bhtyrbyr/robotKolBitirmeProjesi/3D/Motaj/Robot Kol Montaj.SLDASM

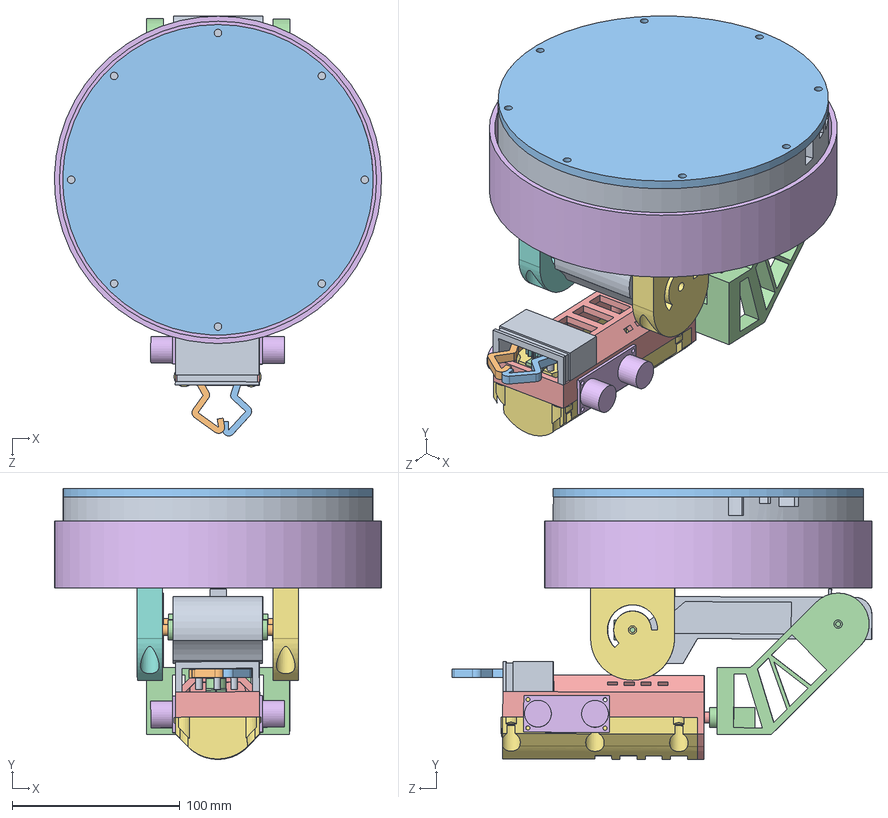
[picture p23: CAD file, 2022-05-09]
3D/Motaj/Robot Kol Montaj.SLDASM
194.9 x 161.5 x 250.3 mm
alt-alan-dönmez
stm32f4-prototip
alt-alan-kapak
Servomotor-mg90s x 7
servomotor-mg90s-180°bağlantı-parçası x 2
döner-parça-alt
yeni-döner-parça-bağlantı
yeni-döner-parça-bağlantı-2
kol-1-ilk-tasarım
servomotor-mg90s-90°bağlantı-parçası x 4
ilk-kol-kapak-tasarım
kol-2-parça-1-test
kol-3-alt-parça-test
HC-SR04 x 2
kol-3-kapak-test
Metric - Spur gear 1M 10T 14.5PA 5FW ---S10N75H50L4N x 2
çark-kutusu
kol-uzun
kısa-kol-güncel
