bhtyrbyr/robotKolBitirmeProjesi/3D/Parçalar/alt-alan-kapak.SLDPRT

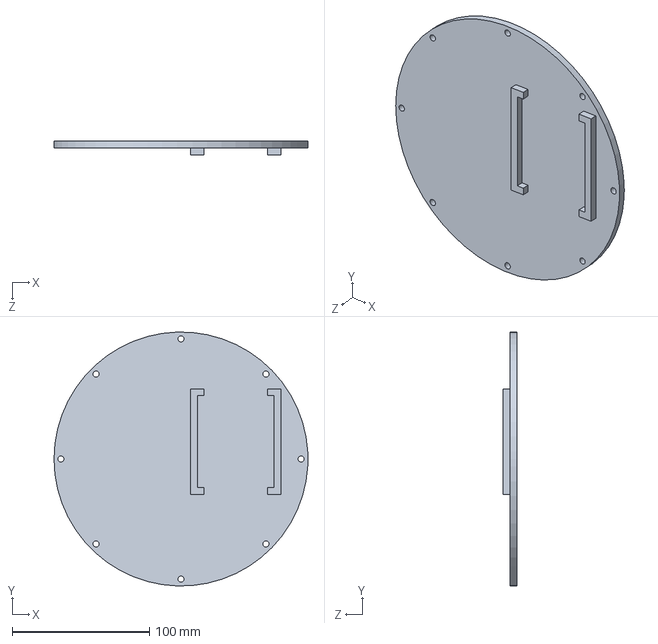
[picture p24: CAD file, 2022-05-09]
3D/Parçalar/alt-alan-kapak.SLDPRT
185.0 x 184.9 x 10.0 mm
