bhtyrbyr/robotKolBitirmeProjesi/3D/Parçalar/döner-parça-alt-bağlantı-2.SLDPRT

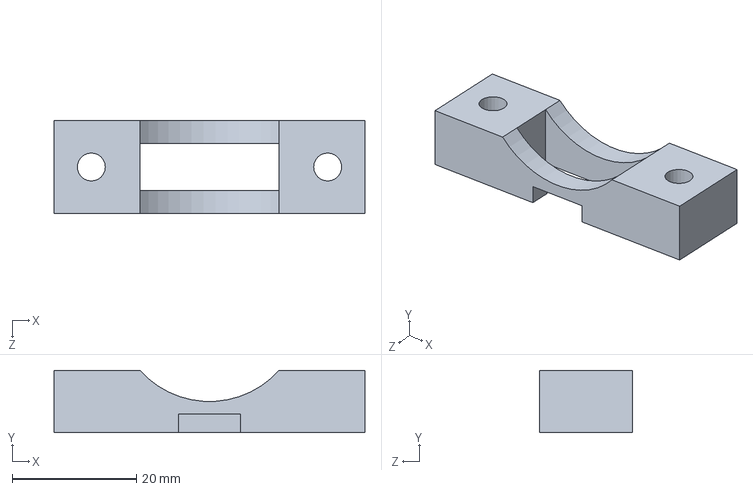
[picture p25: CAD file, 2022-05-09]
3D/Parçalar/döner-parça-alt-bağlantı-2.SLDPRT
50.0 x 10.0 x 15.0 mm
