bhtyrbyr/robotKolBitirmeProjesi/3D/Parçalar/döner-parça-alt.SLDPRT

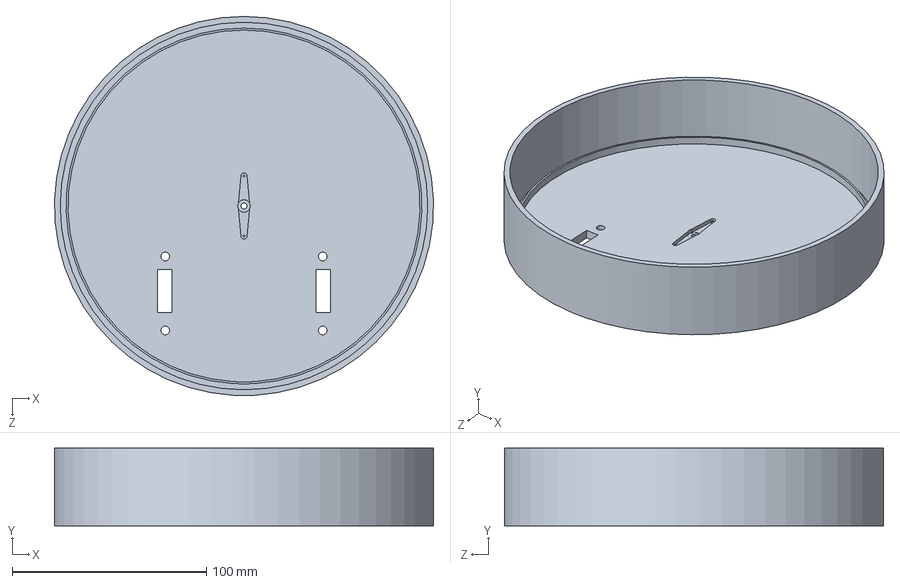
[picture p26: CAD file, 2022-05-09]
3D/Parçalar/döner-parça-alt.SLDPRT
194.9 x 40.0 x 195.0 mm
