bhtyrbyr/robotKolBitirmeProjesi/3D/Parçalar/servomotor-mg90s-90°bağlantı-parçası.SLDPRT

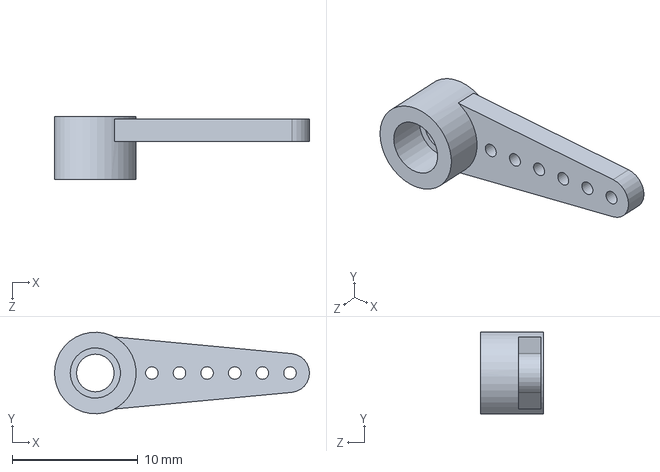
[picture p27: CAD file, 2022-05-09]
3D/Parçalar/servomotor-mg90s-90°bağlantı-parçası.SLDPRT
20.3 x 6.49 x 5.00 mm
