bhtyrbyr/robotKolBitirmeProjesi/3D/Parçalar/stm32f4-prototip.SLDPRT

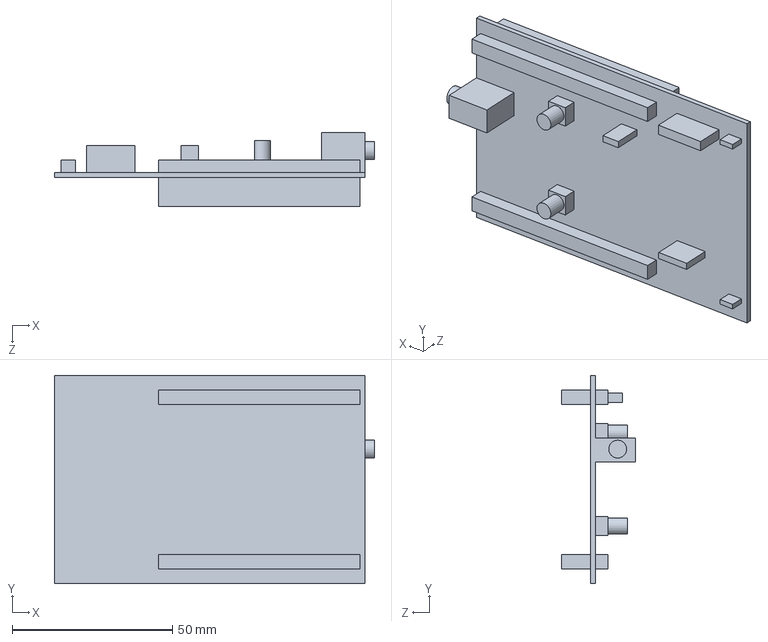
[picture p28: CAD file, 2022-05-09]
3D/Parçalar/stm32f4-prototip.SLDPRT
100.0 x 65.0 x 23.0 mm
