bhtyrbyr/robotKolBitirmeProjesi/3D/Parçalar/kol-uzun.SLDPRT

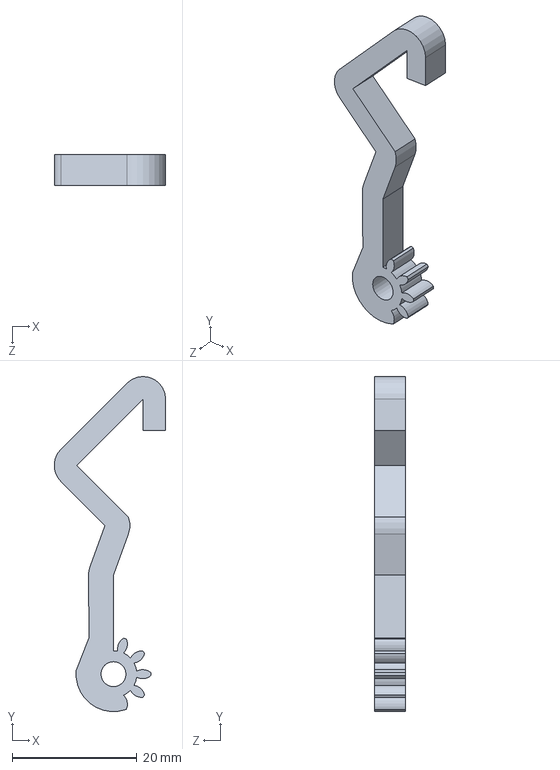
[picture p29: CAD file, 2022-05-09]
3D/Parçalar/kol-uzun.SLDPRT
17.8 x 53.6 x 5.00 mm
