bhtyrbyr/robotKolBitirmeProjesi/3D/Parçalar/HC-SR04.SLDPRT

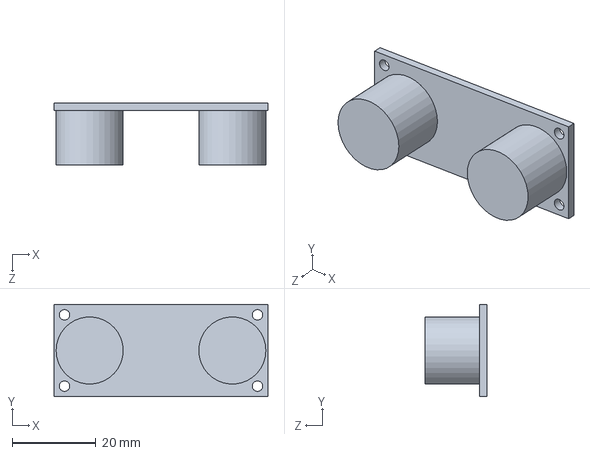
[picture p30: CAD file, 2022-05-09]
3D/Parçalar/HC-SR04.SLDPRT
51.0 x 22.0 x 14.8 mm
