bhtyrbyr/robotKolBitirmeProjesi/3D/Parçalar/alt-alan-dönmez.SLDPRT

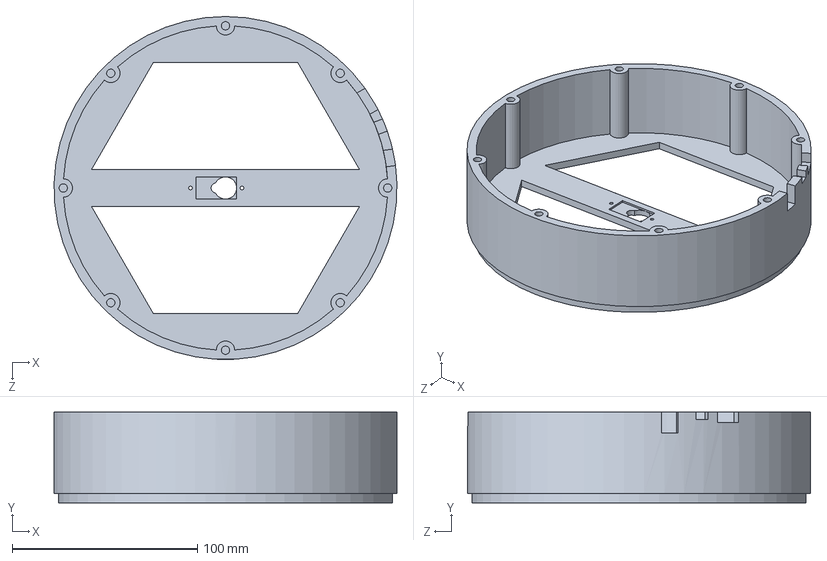
[picture p31: CAD file, 2022-05-09]
3D/Parçalar/alt-alan-dönmez.SLDPRT
184.9 x 49.0 x 185.0 mm
