bhtyrbyr/robotKolBitirmeProjesi/3D/Parçalar/kol-1-ilk-tasarım.SLDPRT

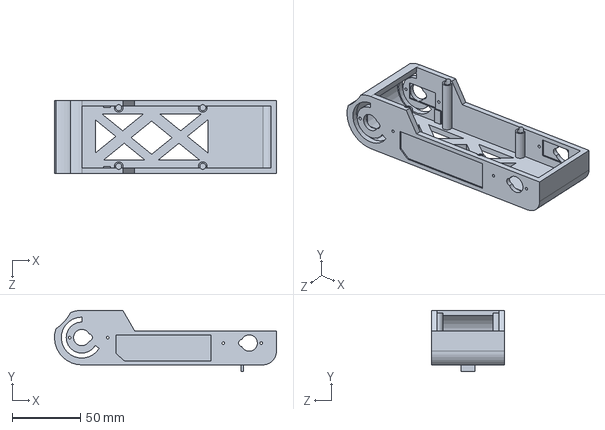
[picture p32: CAD file, 2022-05-09]
3D/Parçalar/kol-1-ilk-tasarım.SLDPRT
162.5 x 45.0 x 53.4 mm
