bhtyrbyr/robotKolBitirmeProjesi/3D/Parçalar/Servomotor-mg90s.SLDPRT

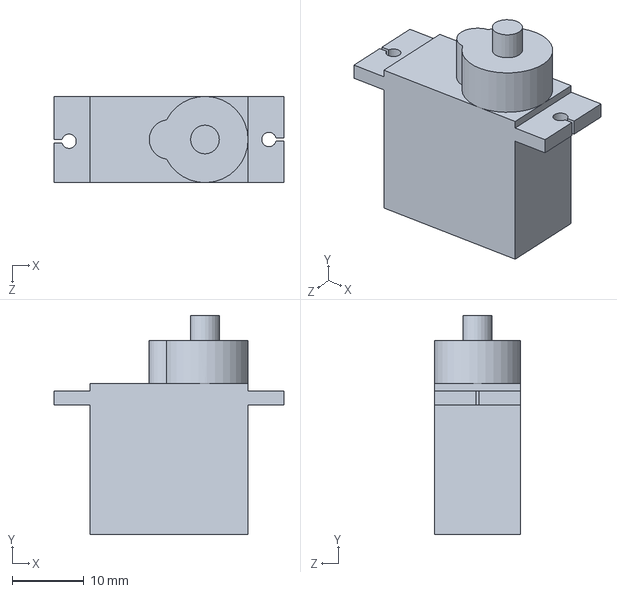
[picture p33: CAD file, 2022-05-09]
3D/Parçalar/Servomotor-mg90s.SLDPRT
32.0 x 30.5 x 12.0 mm
