bhtyrbyr/robotKolBitirmeProjesi/3D/Parçalar/pca9685.SLDPRT

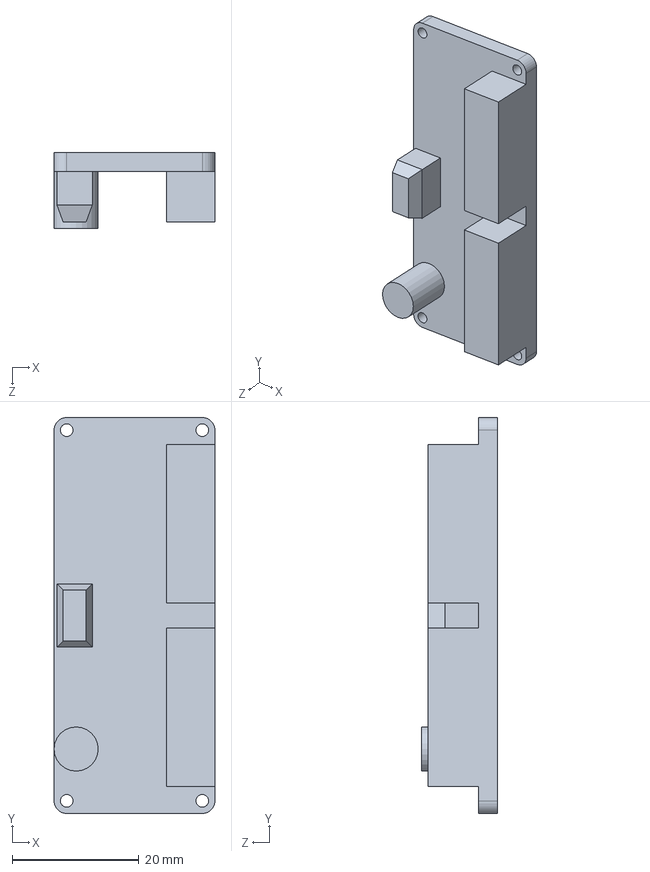
[picture p34: CAD file, 2022-05-09]
3D/Parçalar/pca9685.SLDPRT
25.4 x 62.5 x 12.0 mm
