bhtyrbyr/robotKolBitirmeProjesi/3D/Parçalar/test-bağlantı.SLDPRT

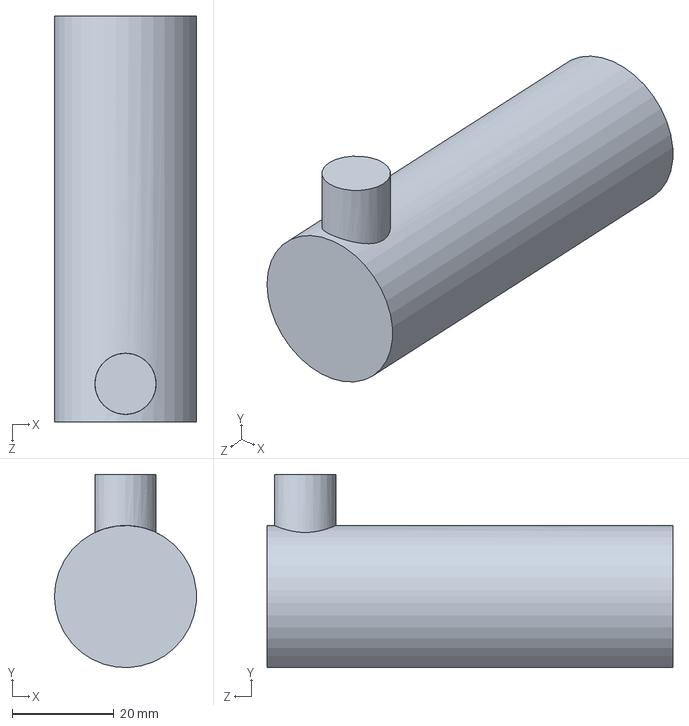
[picture p35: CAD file, 2022-05-09]
3D/Parçalar/test-bağlantı.SLDPRT
28.0 x 38.0 x 80.0 mm
