bhtyrbyr/robotKolBitirmeProjesi/3D/Parçalar/ilk-kol-kapak-tasarım.SLDPRT

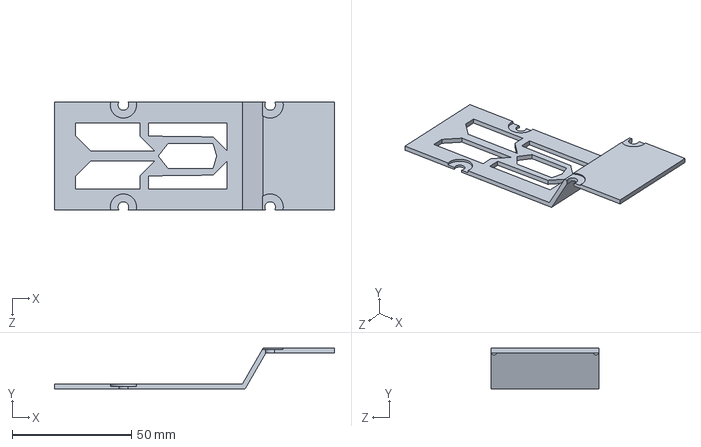
[picture p36: CAD file, 2022-05-09]
3D/Parçalar/ilk-kol-kapak-tasarım.SLDPRT
117.5 x 17.0 x 45.4 mm
