bhtyrbyr/robotKolBitirmeProjesi/3D/Parçalar/yeni-döner-parça-bağlantı-2.SLDPRT

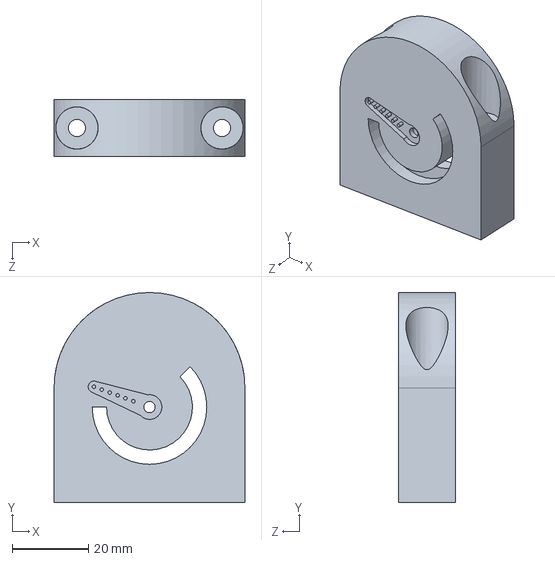
[picture p37: CAD file, 2022-05-09]
3D/Parçalar/yeni-döner-parça-bağlantı-2.SLDPRT
50.0 x 55.0 x 15.0 mm
