bhtyrbyr/robotKolBitirmeProjesi/3D/Parçalar/servomotor-mg90s-180°bağlantı-parçası.SLDPRT

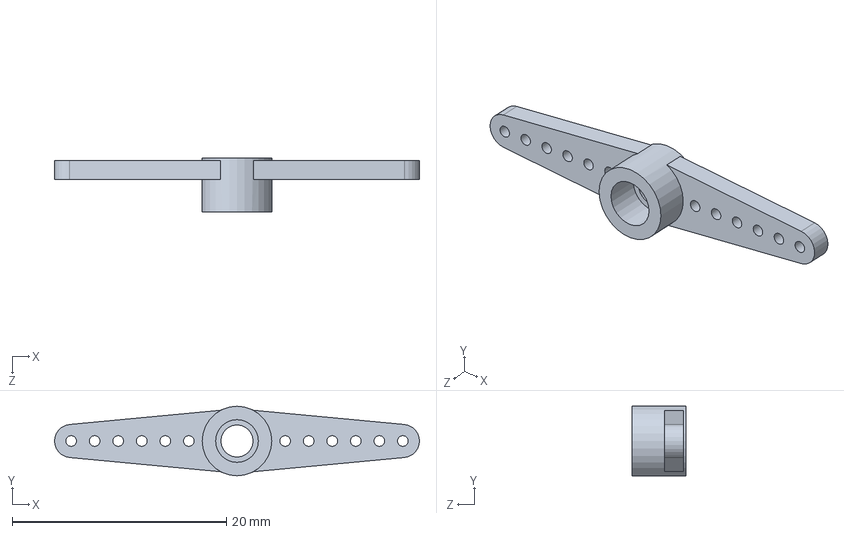
[picture p38: CAD file, 2022-05-09]
3D/Parçalar/servomotor-mg90s-180°bağlantı-parçası.SLDPRT
34.1 x 6.50 x 5.00 mm
