bhtyrbyr/robotKolBitirmeProjesi/3D/Parçalar/kol-kısa.SLDPRT

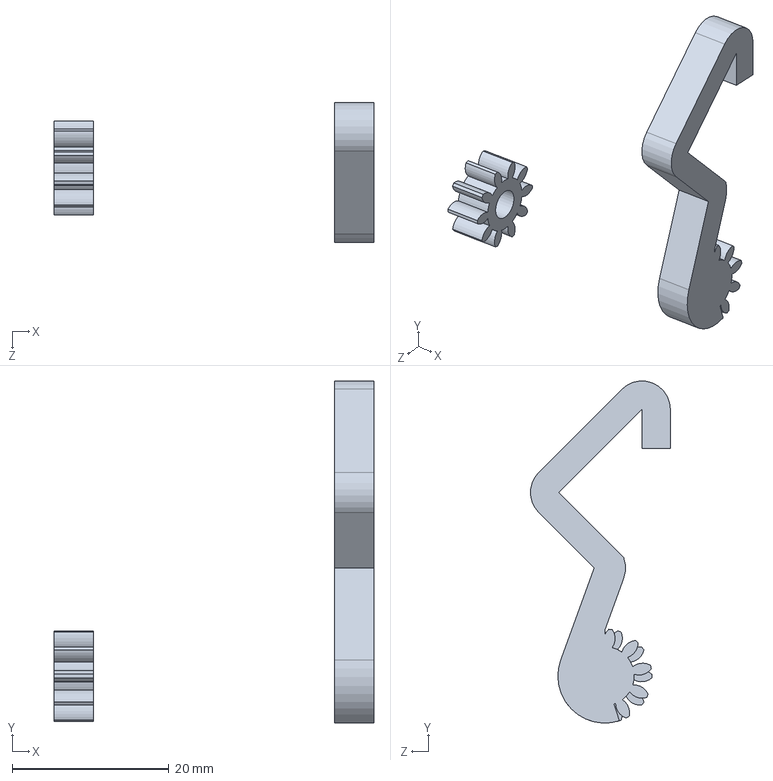
[picture p39: CAD file, 2022-05-09]
3D/Parçalar/kol-kısa.SLDPRT
40.8 x 43.6 x 17.8 mm
