bhtyrbyr/robotKolBitirmeProjesi/3D/Parçalar/kol-3-alt-parça-test.SLDPRT

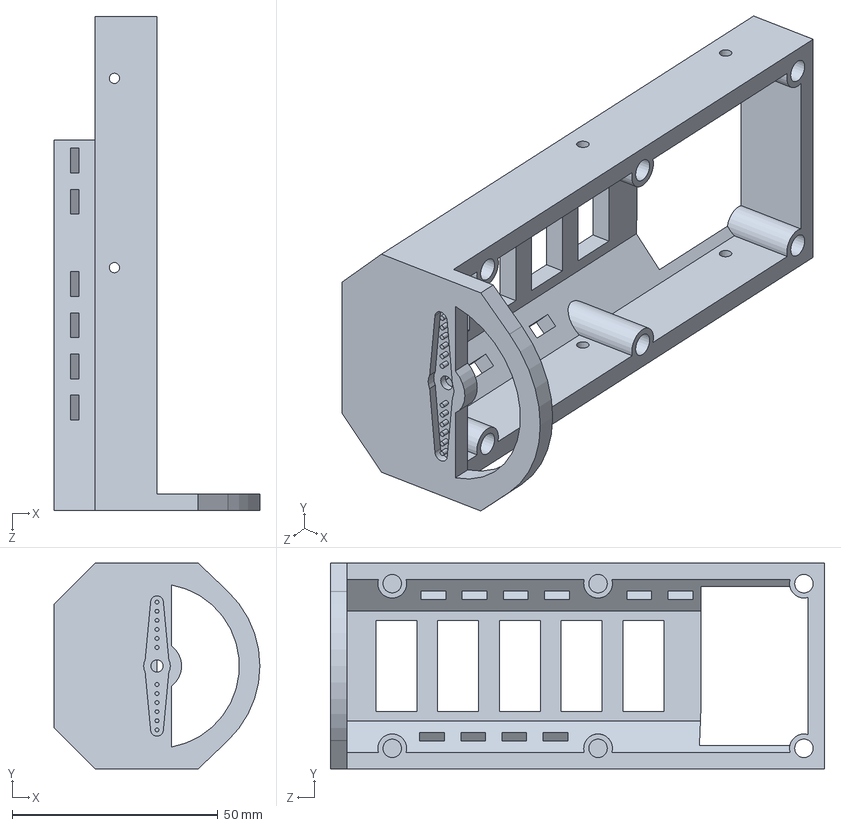
[picture p40: CAD file, 2022-05-09]
3D/Parçalar/kol-3-alt-parça-test.SLDPRT
50.0 x 50.0 x 120.0 mm
