bhtyrbyr/robotKolBitirmeProjesi/3D/Parçalar/kol-3-kapak-test.SLDPRT

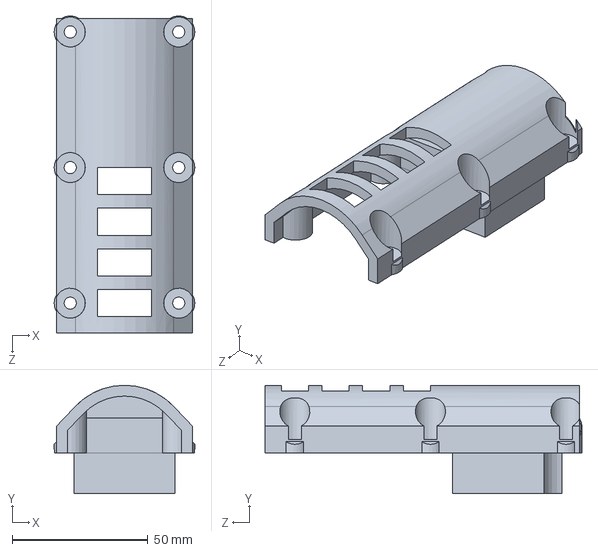
[picture p41: CAD file, 2022-05-09]
3D/Parçalar/kol-3-kapak-test.SLDPRT
51.8 x 40.0 x 116.9 mm
