bhtyrbyr/robotKolBitirmeProjesi/3D/Parçalar/kısa-kol-güncel.SLDPRT

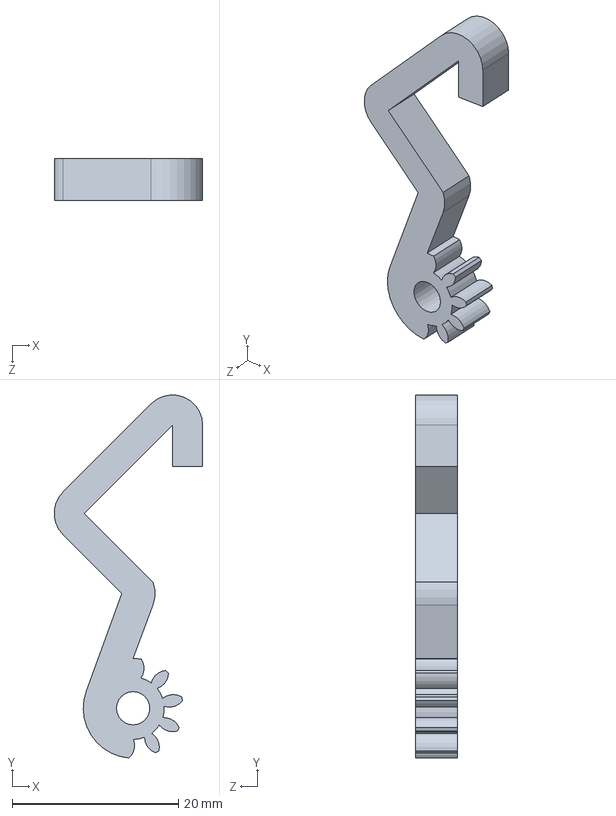
[picture p42: CAD file, 2022-05-09]
3D/Parçalar/kısa-kol-güncel.SLDPRT
17.8 x 43.6 x 5.00 mm
