bhtyrbyr/robotKolBitirmeProjesi/3D/Parçalar/kol-2-parça-1-test.SLDPRT

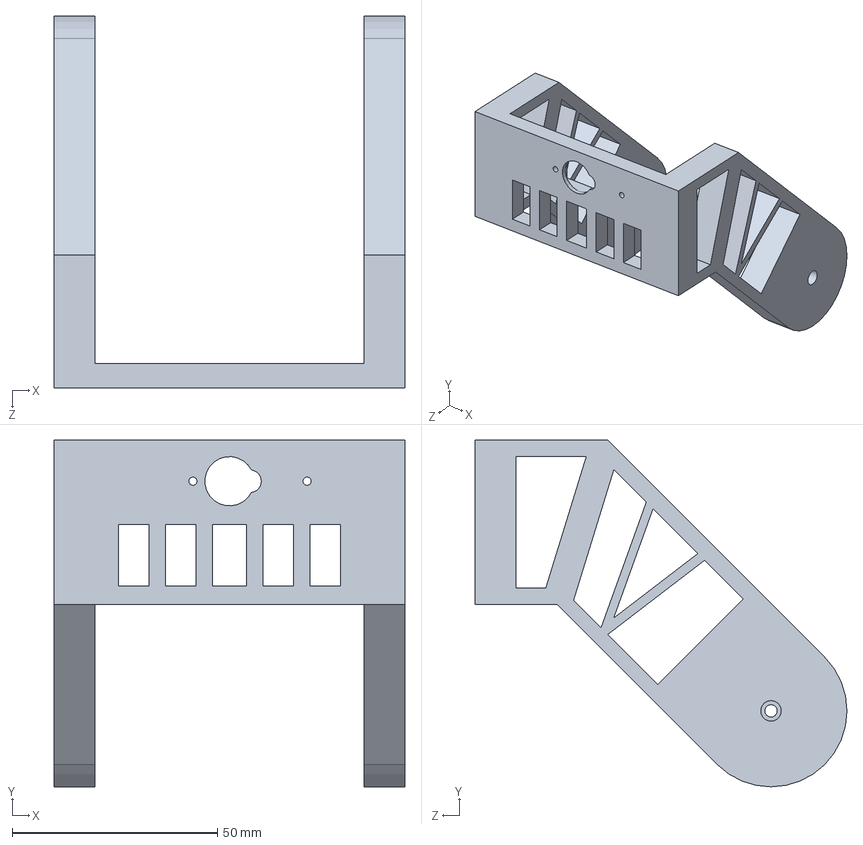
[picture p43: CAD file, 2022-05-09]
3D/Parçalar/kol-2-parça-1-test.SLDPRT
85.4 x 84.4 x 90.6 mm
