bhtyrbyr/robotKolBitirmeProjesi/3D/Parçalar/döner-parça-alt-bağlantı.SLDPRT

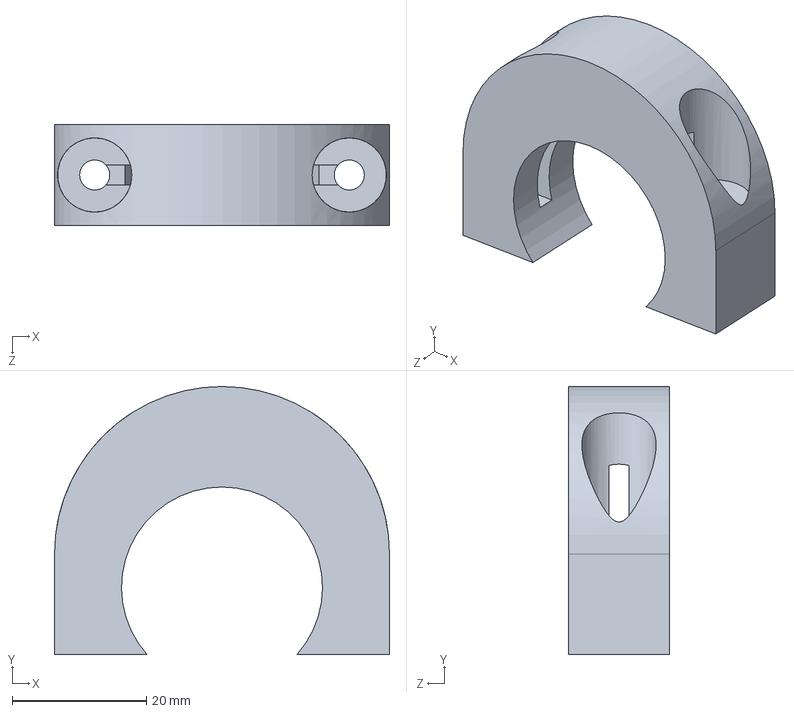
[picture p45: CAD file, 2022-05-09]
3D/Parçalar/döner-parça-alt-bağlantı.SLDPRT
50.0 x 40.0 x 15.0 mm
