bhtyrbyr/robotKolBitirmeProjesi/(list of files, cad)

Other CAD files:
3D/Motaj/Robot Kol Montaj.SLDDRW
