bhtyrbyr/robotKolBitirmeProjesi/3D/Motaj/Robot Kol Montaj.pdf

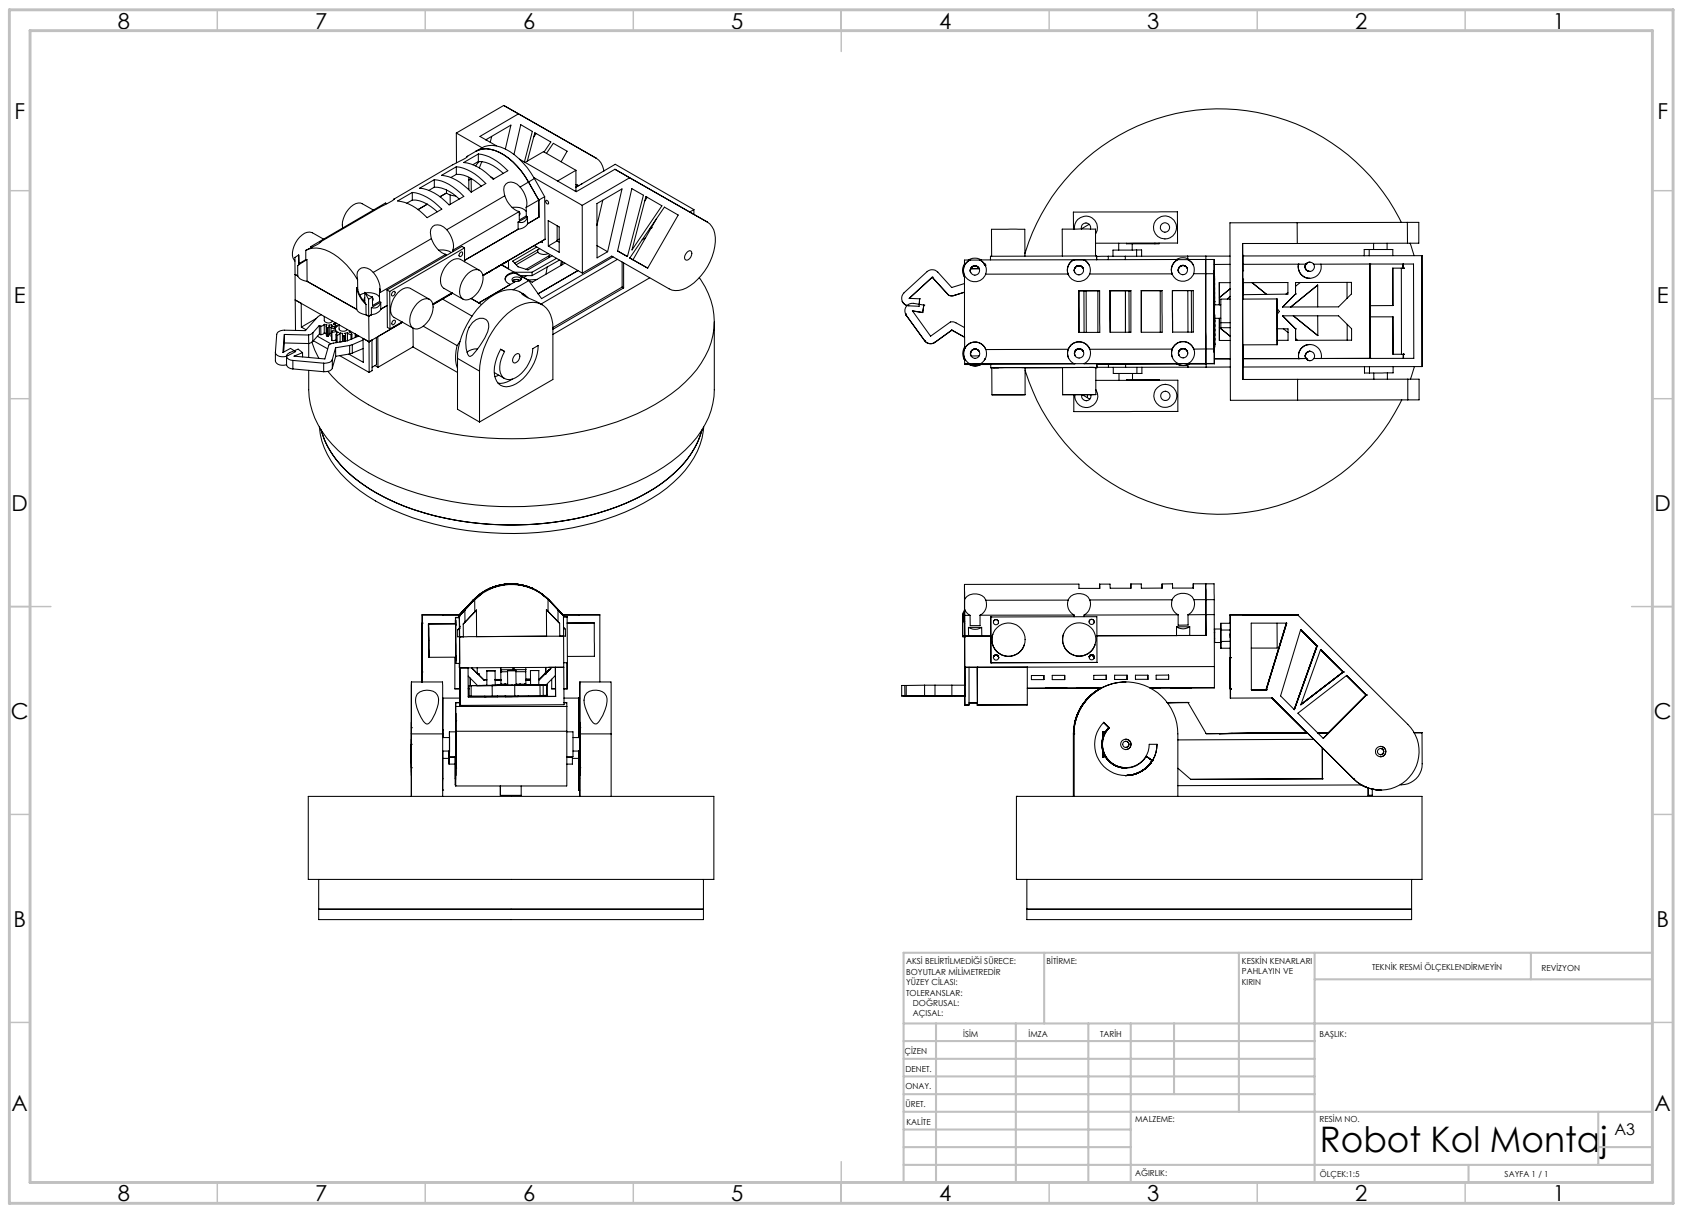
[picture p46: page 1]
BİTİRME:; KESKİN KENARLARI; PAHLAYIN VE; TEKNİK RESMİ ÖLÇEKLENDİRMEYİN; REVİZYON; ÖLÇEK:1:5; SAYFA 1 / 1

AKSİ BELİRTİLMEDİĞİ SÜRECE:
BOYUTLAR MİLİMETREDİR
YÜZEY CİLASI:
TOLERANSLAR:
DOĞRUSAL:
AÇISAL:

İSİM | İMZA | TARİH | | | | BAŞLIK:

ÇİZEN
DENET.
ONAY.
ÜRET.
KALİTE | | | | MALZEME: | RESİM NO. Robot Kol Montaj | A3
